wrd-blog/Magloop-RC-capacitor-servo/img/controller_exterior.jpg

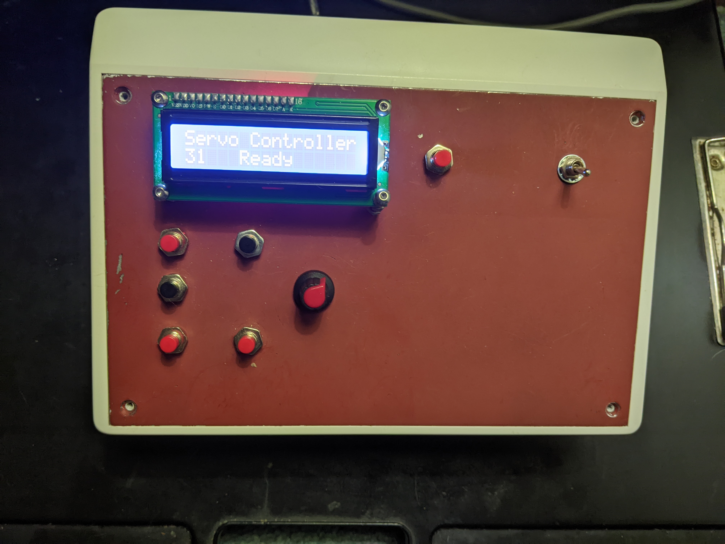
img/controller_exterior.jpg
