wrd-blog/Magloop-RC-capacitor-servo/img/controller_interior.jpg

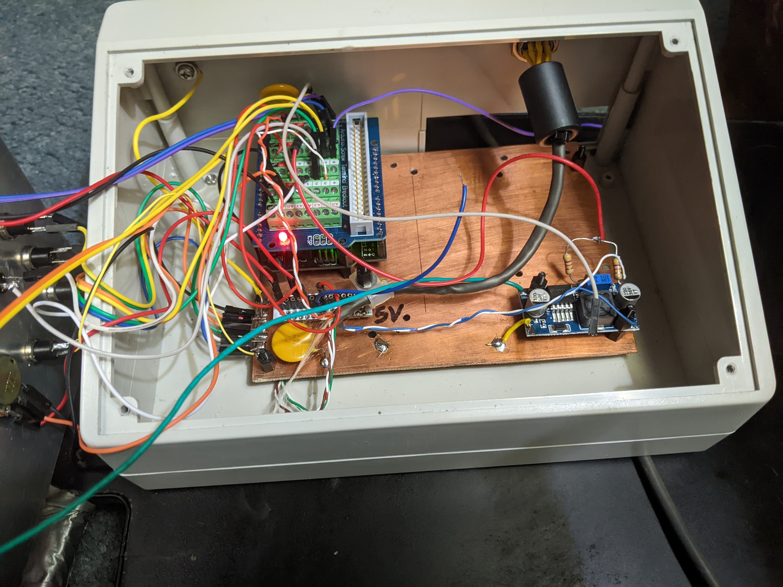
img/controller_interior.jpg
