wrd-blog/Magloop-RC-capacitor-servo/img/controller_back_panel.jpg

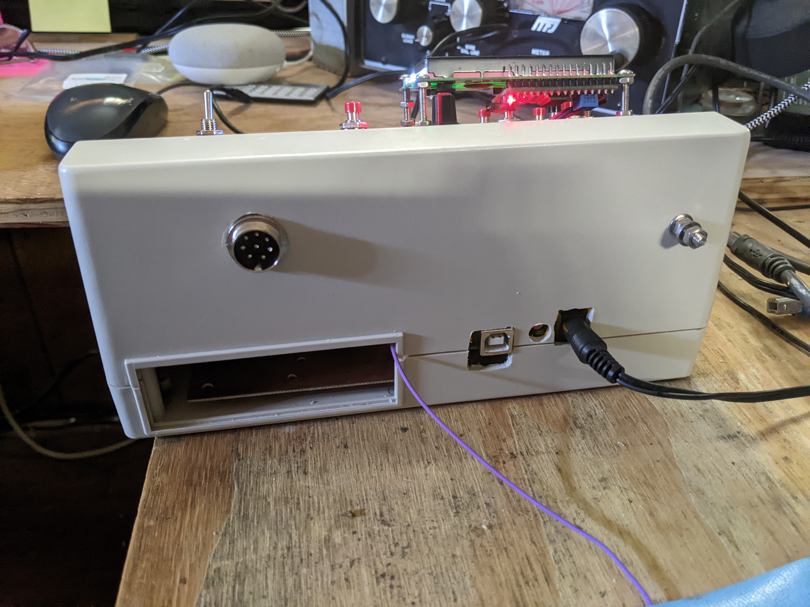
img/controller_back_panel.jpg
