wrd-blog/Magloop-RC-capacitor-servo/Docs/PWM_servo_controller_schematic.pdf

# UNO

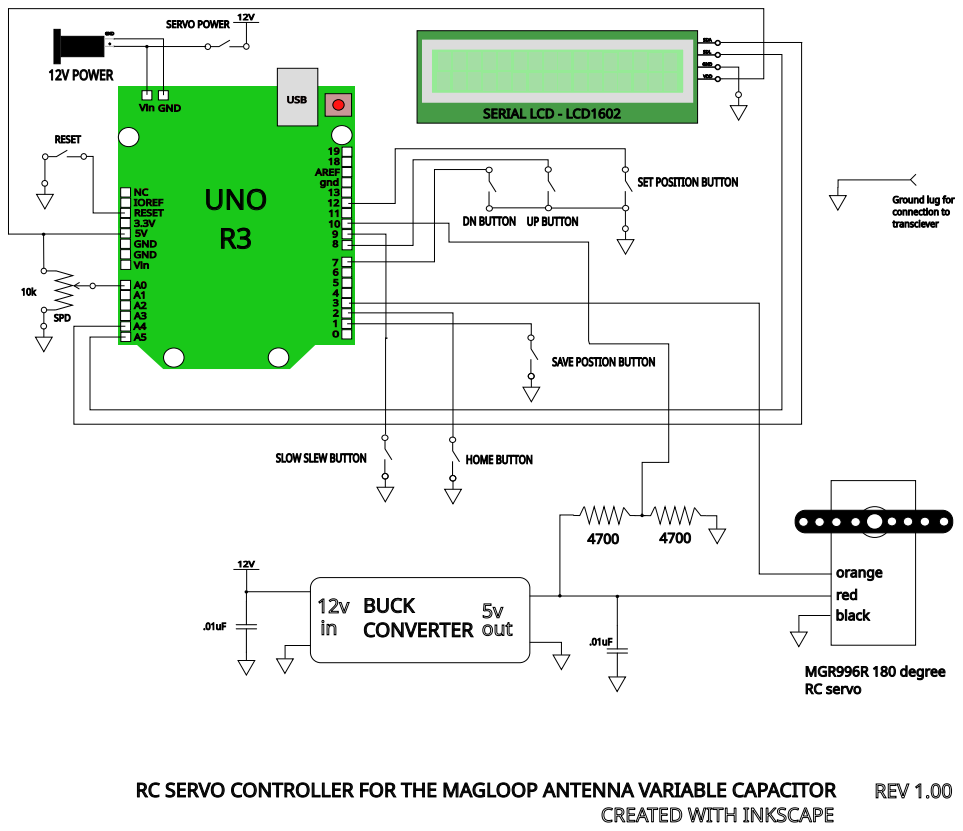
[picture p4: page 1]
gnd; AREF; Vin; GND; RESET; IOREF; USB; SPD; SDA; SDL; VDD; SERIAL LCD - LCD1602; + 12V POWER; SERVO POWER; BUCK CONVERTER; red black; orange; HOME BUTTON; MGR996R 180 degree RC servo

SET POSITION BUTTON

Ground lug for
connection to
transciever

DN BUTTON UP BUTTON

SAVE POSTION BUTTON

SLOW SLEW BUTTON

RC SERVO CONTROLLER FOR THE MAGLOOP ANTENNA VARIABLE CAPACITOR
