wrd-blog/Magloop-RC-capacitor-servo/(commit log)

2023-12-15 Add files via upload
    Minor schematic corrections.
2023-12-15 Schematic corrections
2023-12-15 Redesign note added
    The hardware is being redesigned to add a PID controller to the server to solve a problem with servo jitter.
